AlexRVoid/Esim-data-transmission-module/README.md

# Esim-data-transmission-module
# First comint SonGoku
