AlexRVoid/Esim-data-transmission-module/Документация/schematic.pdf

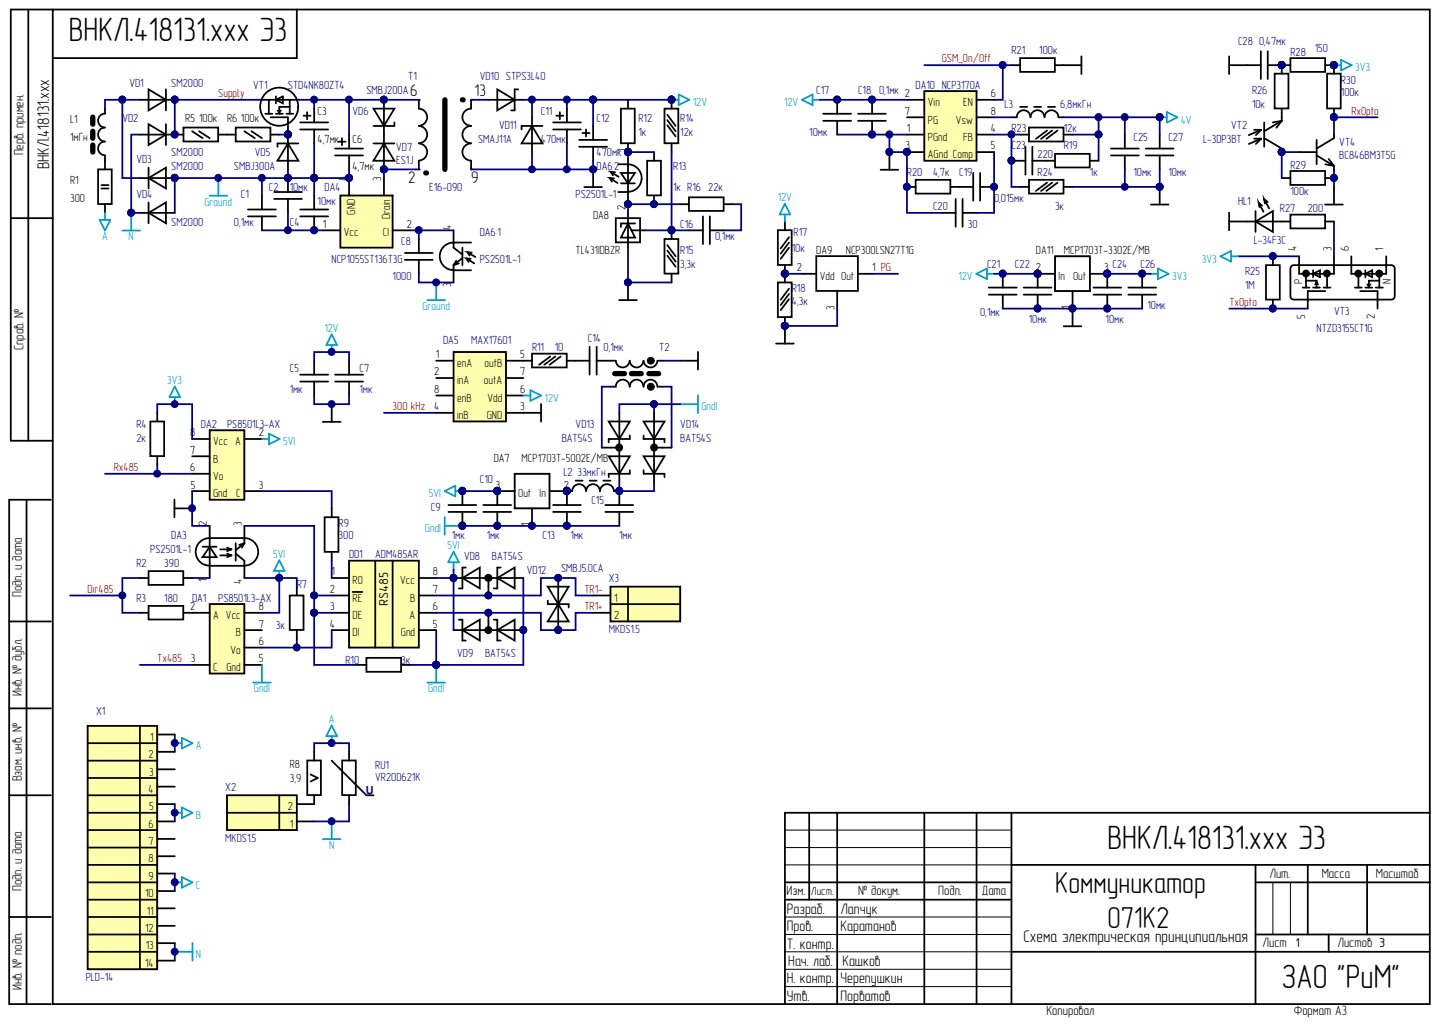
[picture p5: page 1]

Инв. № подп. Подп. и дата Взам. инв. № Инв. № дубл. Подп. и дата Справ. № Перв. примен.

Н. контр. | Черепушкин
Утв. | Порватов

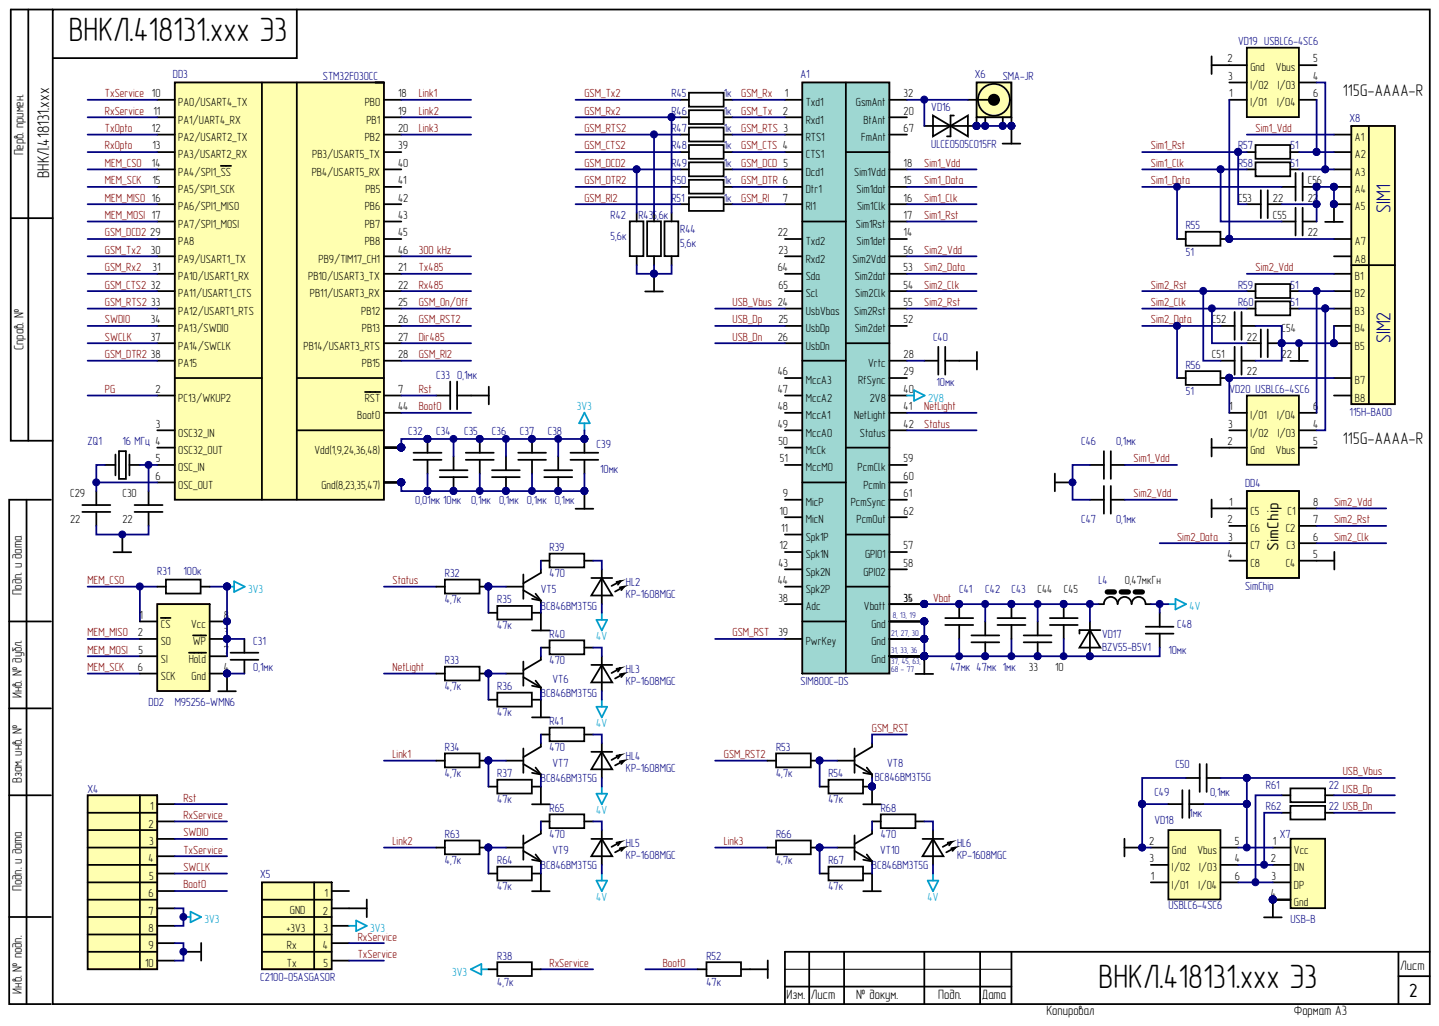
[picture p6: page 2]

Инв. № подп. Подп. и дата Взам. инв. № Инв. № дубл. Подп. и дата Справ. № Перв. примен.

Spk1N 12 Spk1P 11 | GPIO2
Spk2N 43 | | 58 GPIO1 57
