AlexRVoid/Esim-data-transmission-module/PCB_Project_1/Project Outputs for PCB_Project/Job1.PDF

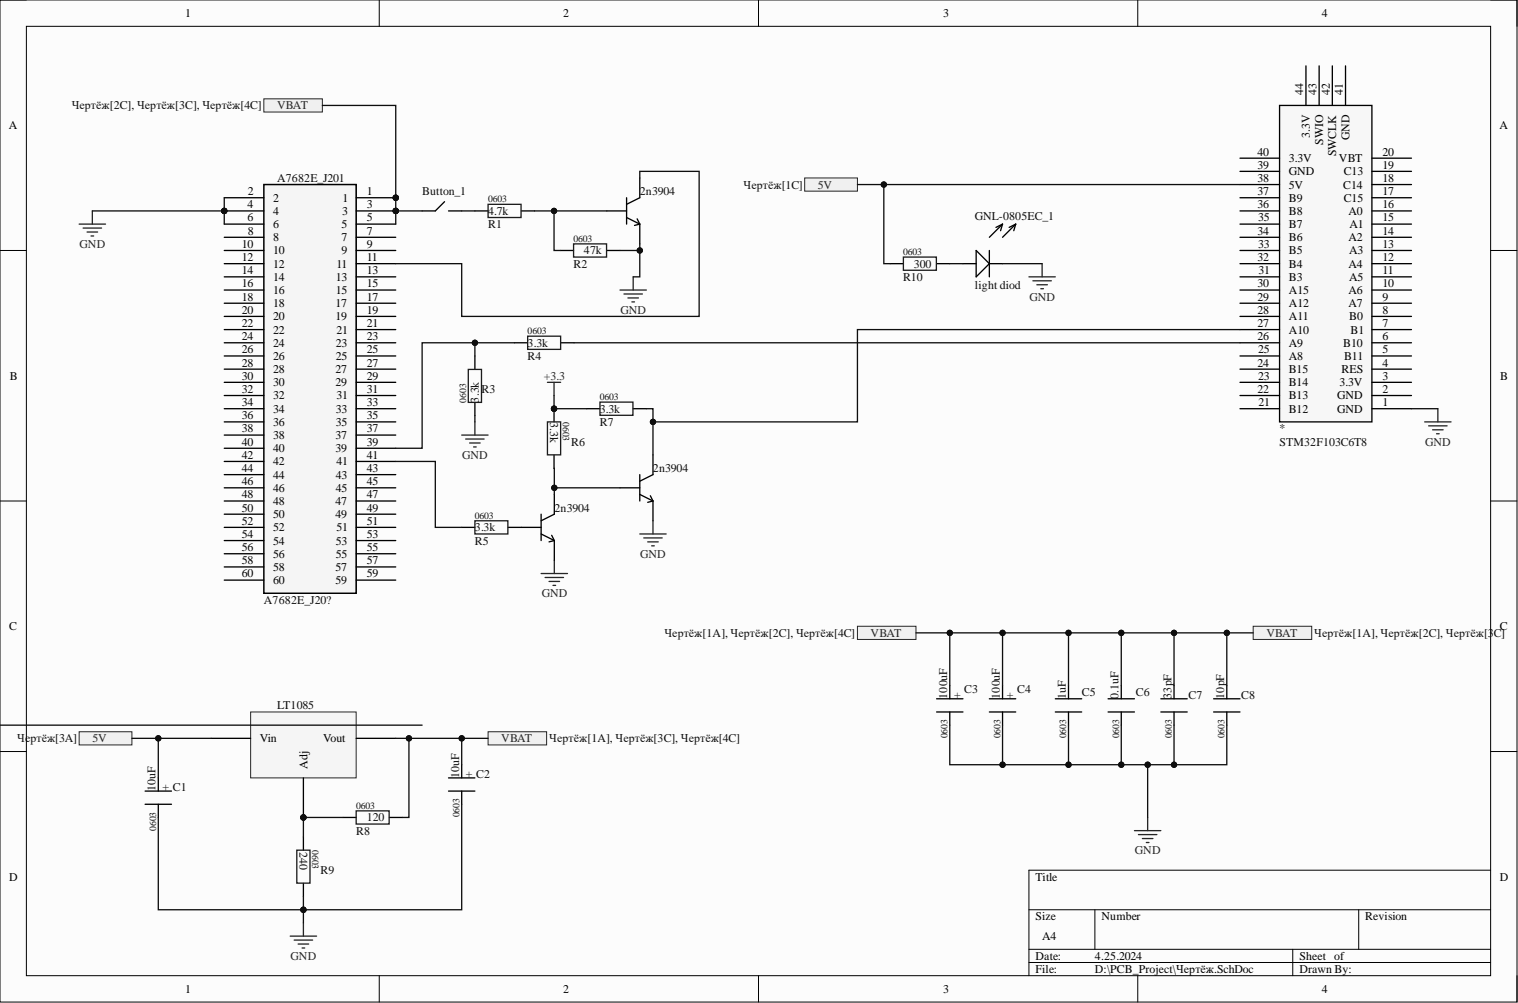
[picture p7: page 1]
