AlexRVoid/Esim-data-transmission-module/(list of files, drawings)

Other design files:
PCB_Project_1/Component.SchLib
PCB_Project_1/eSIM.SchDoc
PCB_Project_1/PCB1.PcbDoc
PCB_Project_1/PCB_Project_1.PrjPcb
PCB_Project_1/PcbLib1.PcbLib
PCB_Project_1/Plat.SchLib
PCB_Project_1/Чертёж.SchDoc
