AlexRVoid/Esim-data-transmission-module/(commit log)

2024-03-25 Добавлены основные компоненты
    [PCB_Project.PrjPcb, Schlib1.SchLib, Schlib2.SchLib, Sheet1.SchDoc]
2024-03-26 Распиновка компонентов из инета
    Распиновка для simcom a7682e и для stm32f103c8t6
2024-04-29 выгрузка наработок
    [Component.SchLib, PCB_Project.PrjPcb, PcbLib1.PcbLib, Plat.SchLib, Schlib1.SchLib, Schlib2.SchLib, Sheet1.SchDoc, Чертёж.SchDoc]
2024-04-29 доработан код общения
2024-04-29 добавил посадочные места для компо
    [Component.SchLib, PCB_Project_1.PrjPcb, PcbLib1.PcbLib, Plat.SchLib, Чертёж.SchDoc]
2024-05-13 +схема
    [Component.SchLib, PCB1.PcbDoc, PCB_Project_1.PrjPcb, PcbLib1.PcbLib, Plat.SchLib, eSIM.SchDoc, Чертёж.SchDoc]
2024-05-13 Исправил схему
    [PCB1.PcbDoc]
2024-05-15 Отлажена отправка и получение сообщений
2024-05-16 логи tcp команд
2024-05-31 Отправка сообщений по TCP/IP
2024-06-07 Обновление кода
    Требуется доработка отправка по TCP/IP
2024-06-13 Финальная версия кода
2024-06-13 Исправление ошибки компиляции
2024-06-13 Добавлено описание
2024-06-14 Правки
    [Component.SchLib, PCB1.PcbDoc, PCB_Project.PrjPcb, PCB_Project_1.PrjPcb, PcbLib1.PcbLib, Plat.SchLib, Чертёж.SchDoc]
2024-06-20 Добавлен паспорт в документацию
